sparkfun/SparkFun_Red_Vision_Camera_Board_HM01B0/README.md

SparkFun Red Vision Camera Board - HM01B0 (Color)
================================================
SparkFun Red Vision Camera Board - HM01B0 (Color) (https://www.sparkfun.com/sparkfun-red-vision-camera-board-hm01b0-color.html)

The SparkFun Red Vision Camera Board - HM01B0 is a breakout board for the HM01B0 320 x 320 color camera module from Himax<sup>&copy;</sup>. The Camera Board breaks out all the pins from the HM01B0's ribbon cable to three sets of 0.1"-spaced plated through-hole (PTH) headers for users to easily access. We designed the Red Vision Camera Board - HM01B0 to work both as a standalone breakout board and also as a compliment to the [SparkFun Red Vision Touch Display for Pico](https://www.sparkfun.com/sparkfun-red-vision-touch-display-for-pico.html) to add live image processing as well as advanced features including object and contour detection among others to the [Experiential Robotics Platform (XRP) Kit](https://www.sparkfun.com/experiential-robotics-platform-xrp-kit.html) using a SparkFun MicroPython port of the popular OpenCV image processing library. We've included both of these boards in the [SparkFun Red Vision Kit for XRP ](https://www.sparkfun.com/sparkfun-pico-vision-kit-for-xrp.html) for those who'd like to get everything they need to quickly and easily add a camera and touchscreen display to their XRP Robot with no soldering required. **Note:** This standalone version of the Red Vision Camera Board - HM01B0 does *not* come with headers soldered to the board.

Repository Contents
-------------------
 
* **/Hardware** - Eagle design files (.brd, .sch)

Documentation
--------------
* **[SparkFun Red Vision MicroPython Package](https://github.com/sparkfun/red_vision/tree/main)** - MicroPython package for the SparkFun Red Vision Camera Board - HM01B0 (Color).
* **[SparkFun MicroPython OpenCV](https://github.com/sparkfun/micropython-opencv)** - MicroPython port of OpenCV code library.
* **[SparkFun MicroPython Firmware Releases](https://github.com/sparkfun/micropython/releases)** - SparkFun MicroPython firmware releases.
* **[SparkFun Red Vision Kit for XRP Hookup Guide](https://docs.sparkfun.com/SparkFun_Red_Vision_Kit_for_XRP/introduction)** - Basic hookup guide for the SparkFun Red Vision Kit for XRP (includes the Red Vision Camera Board - HM01B0).

Product Versions
----------------
* [SEN-29468](https://www.sparkfun.com/sparkfun-red-vision-camera-board-hm01b0-color.html) - Initial release of the Red Vision Camera Board - HM01B0 (Color)

License Information
-------------------

This product is _**open source**_! 

Please review the LICENSE.md file for license information. 

If you have any questions or concerns on licensing, please contact technical support on our [SparkFun forums](https://forum.sparkfun.com/viewforum.php?f=152).

Distributed as-is; no warranty is given.

- Your friends at SparkFun.
