sparkfun/SparkFun_Red_Vision_Camera_Board_HM01B0/Hardware/SparkFun_Red_Vision_Camera_Board_HM01B0.kicad_sch

## KiCad design Hardware/SparkFun_Red_Vision_Camera_Board_HM01B0.kicad_sch (2025-09-04)

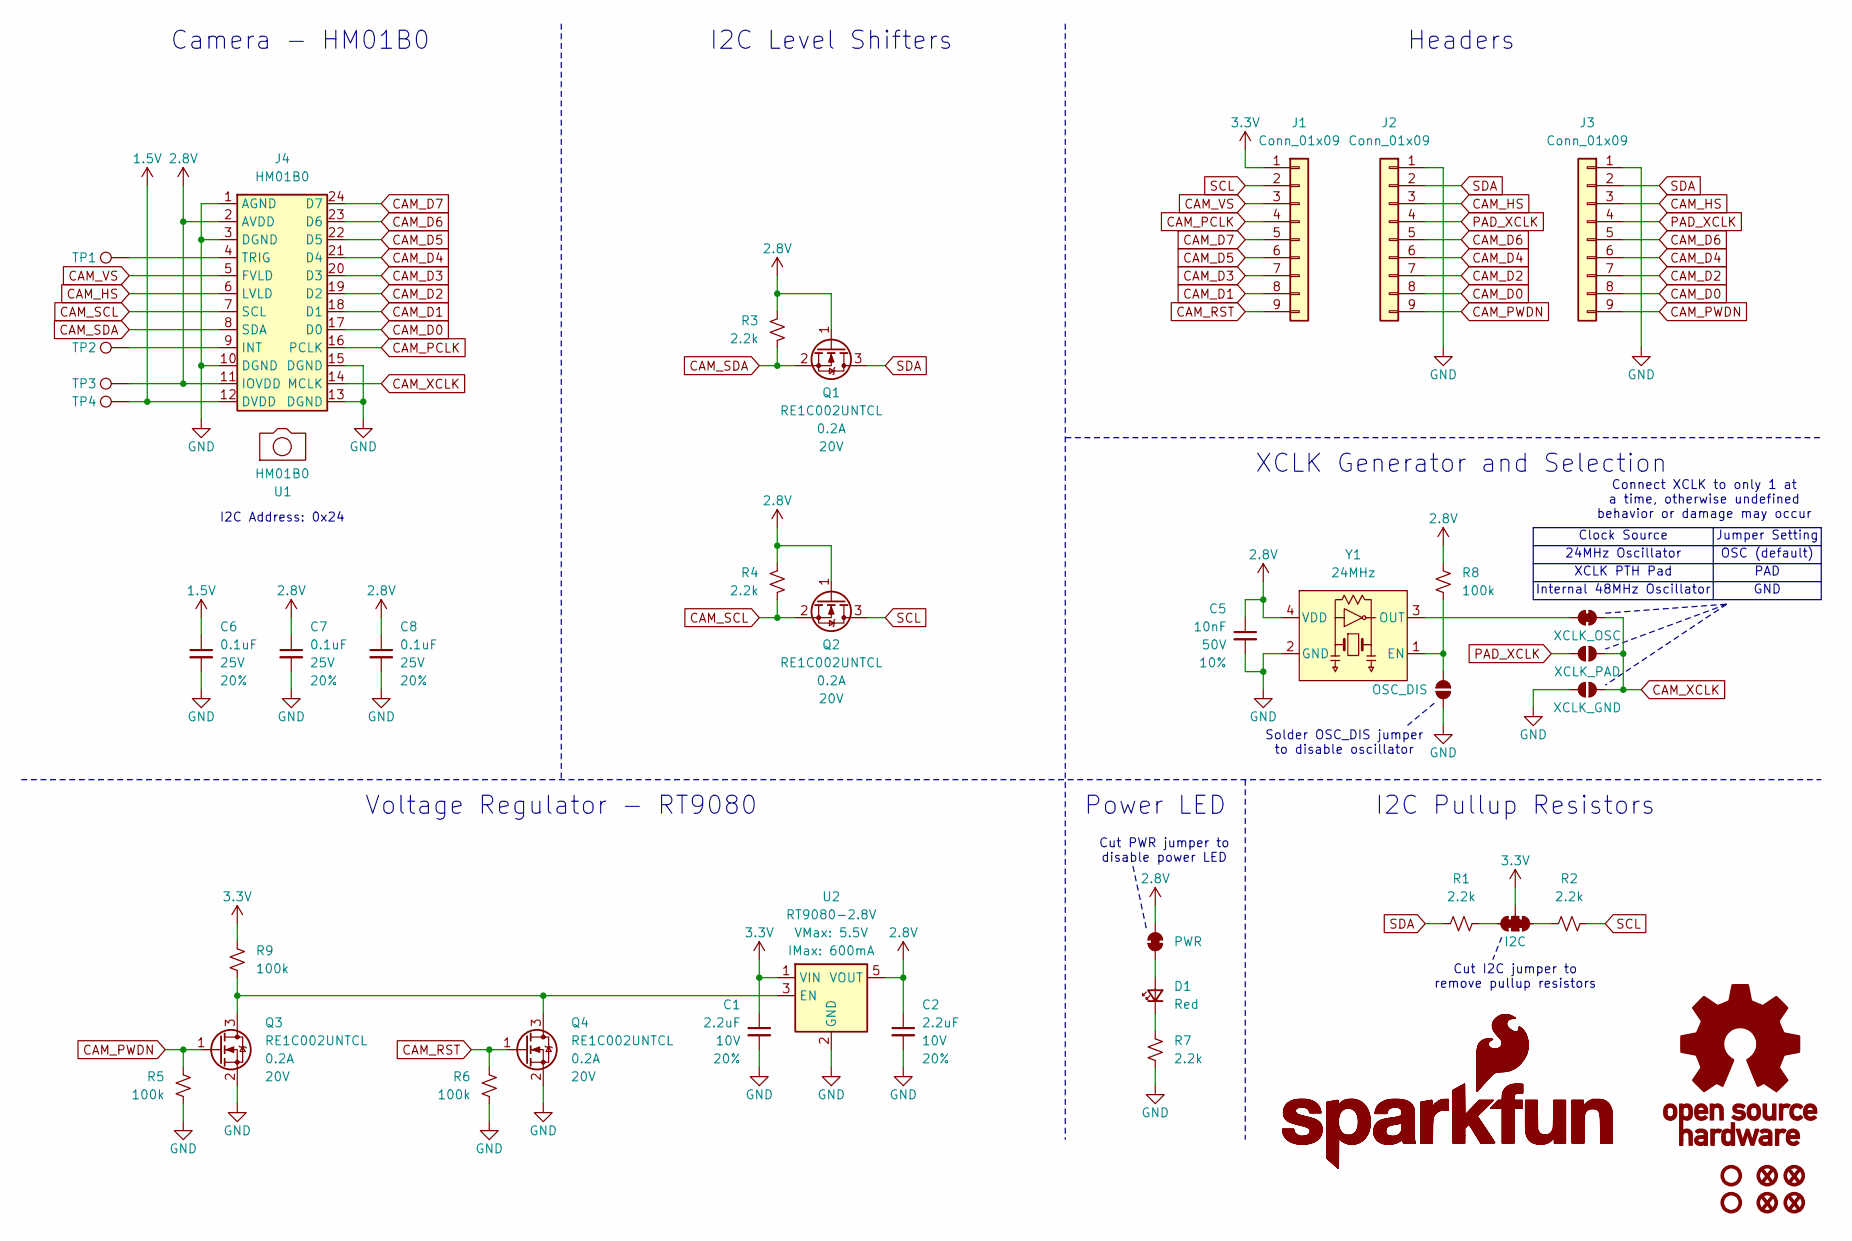
[picture p1: schematic SparkFun_Red_Vision_Camera_Board_HM01B0.kicad_sch]

Parts:
C1, C2: 2.2uF; C_0603_1608Metric; Voltage 10V; Tolerance 20%
C5: 10nF; C_0603_1608Metric; Voltage 50V; Tolerance 10%
C6, C7, C8: 0.1uF; C_0603_1608Metric; Voltage 25V; Tolerance 20%
D1: Red; LED_0603_1608Metric_Red
FID1, FID2, FID3, FID4: Fiducial_0.5mm; Fiducial_0.5mm_Mask1mm
G1: SparkFun_Logo; SparkFun_Logo_8mm
G2: SparkFun_Logo
G3: OSHW_Logo; Creative_Commons_License
J1, J2, J3: Conn_01x09; 1x09
J4: HM01B0; FPC_2x12-1MP_P0.4mm
JP1: I2C; Jumper_3_NC-2_Trace
JP2: XCLK_PAD; Jumper_2_NO_NoSilk
JP3: XCLK_OSC; Jumper_2_NC_Trace_NoSilk
JP5: OSC_DIS; Jumper_2_NO
JP6: XCLK_GND; Jumper_2_NO_NoSilk
JP7: PWR; Jumper_2_NC_Trace
Q1, Q2, Q3, Q4: RE1C002UNTCL; SC-89 SOT-490
R1, R2, R3, R4, R7: 2.2k; R_0603_1608Metric
R5, R6, R8, R9: 100k; R_0603_1608Metric
ST1, ST2: Standoff
TP1, TP2, TP3, TP4: 1.25mm; TestPoint-1.25mm
U1: HM01B0; HM01B0-ANA-00FT870
U2: RT9080-2.8V; SOT23-5
Y1: 24MHz; Crystal_SMD_3.2x2.5mm

Connections:
1.5V: C6.1, J4.12 (DVDD), TP4.1
2.8V: C2.1, C5.1, C7.1, C8.1, J4.2 (AVDD), J4.11 (IOVDD), JP7.2 (B), Q1.1 (G), Q2.1 (G), R3.2, R4.2, R8.2, TP3.1, U2.5 (VOUT), Y1.4 (VDD)
3.3V: C1.1, J1.1, JP1.2 (B), R9.1, U2.1 (VIN)
CAM_D0: J2.8, J3.8, J4.17 (D0)
CAM_D1: J1.8, J4.18 (D1)
CAM_D2: J2.7, J3.7, J4.19 (D2)
CAM_D3: J1.7, J4.20 (D3)
CAM_D4: J2.6, J3.6, J4.21 (D4)
CAM_D5: J1.6, J4.22 (D5)
CAM_D6: J2.5, J3.5, J4.23 (D6)
CAM_D7: J1.5, J4.24 (D7)
CAM_HS: J2.3, J3.3, J4.6 (LVLD)
CAM_PCLK: J1.4, J4.16 (PCLK)
CAM_PWDN: J2.9, J3.9, Q3.1 (G), R5.2
CAM_RST: J1.9, Q4.1 (G), R6.2
CAM_SCL: J4.7 (SCL), Q2.2 (S), R4.1
CAM_SDA: J4.8 (SDA), Q1.2 (S), R3.1
CAM_VS: J1.3, J4.5 (FVLD)
CAM_XCLK: J4.14 (MCLK), JP2.2 (B), JP3.2 (B), JP6.2 (B)
GND: C1.2, C2.2, C5.2, C6.2, C7.2, C8.2, J2.1, J3.1, J4.1 (AGND), J4.3 (DGND), J4.10 (DGND), J4.13 (DGND), J4.15 (DGND), JP5.1 (A), JP6.1 (A), Q3.2 (S), Q4.2 (S), R5.1, R6.1, R7.1, U2.2 (GND), Y1.2 (GND)
unnamed: D1.1 (K), R7.2
unnamed: D1.2 (A), JP7.1 (A)
unnamed: J4.4 (TRIG), TP1.1
unnamed: J4.9 (INT), TP2.1
unnamed: JP1.1 (A), R2.1
unnamed: JP1.3 (C), R1.2
unnamed: JP3.1 (A), Y1.3 (OUT)
unnamed: JP5.2 (B), R8.1, Y1.1 (EN)
unnamed: Q3.3 (D), Q4.3 (D), R9.2, U2.3 (EN)
PAD_XCLK: J2.4, J3.4, JP2.1 (A)
SCL: J1.2, Q2.3 (D), R2.2
SDA: J2.2, J3.2, Q1.3 (D), R1.1

Notes on the sheet:
Connect XCLK to only 1 at a time, otherwise undefined behavior or damage may occur
I2C Address: 0x24
24MHz Oscillator
Solder OSC_DIS jumper to disable oscillator
Jumper Setting
Cut I2C jumper to remove pullup resistors
Camera - HM01B0
Clock Source
Headers
I2C Pullup Resistors
OSC (default)
Voltage Regulator - RT9080
GND
Cut PWR jumper to disable power LED
Power LED
XCLK Generator and Selection
I2C Level Shifters
XCLK PTH Pad
Internal 48MHz Oscillator
PAD
