sparkfun/SparkFun_Red_Vision_Camera_Board_HM01B0/(commit log)

2025-03-12 Add initial design
    [SparkFun_Camera_Board_HM01B0.kicad_pcb, SparkFun_Camera_Board_HM01B0.kicad_sch]
2025-03-12 Silkscreen tweaks
    Move OSHW logo to back
    Add PWR label to power LED
    [SparkFun_Camera_Board_HM01B0.kicad_pcb]
2025-03-12 Actually save the schematic...
    [SparkFun_Camera_Board_HM01B0.kicad_sch]
2025-03-17 Design review updates
    Rearrange power control circuitry in schematic
    Add note to MCLK jumper in schematic
    Change camera connector silk pin labels
    Improve GND continuity
    Increase thermal spoke width
    Change In2.Cu to 2.8V instead of GND
    [SparkFun_Camera_Board_HM01B0.kicad_pcb, SparkFun_Camera_Board_HM01B0.kicad_sch]
2025-03-17 Change regulators to adjustable type
    Using adjustable regulators at least for prototypes. May change back to fixed regulators depending on testing
    [SparkFun_Camera_Board_HM01B0.kicad_pcb, SparkFun_Camera_Board_HM01B0.kicad_sch]
2025-03-17 Fix voltage regulator resistor orders
    Reference voltage is relative to VOUT instead of GND. Why???
    [SparkFun_Camera_Board_HM01B0.kicad_pcb, SparkFun_Camera_Board_HM01B0.kicad_sch]
2025-03-17 Fix HM01B0 PROD_ID
    [SparkFun_Camera_Board_HM01B0.kicad_pcb, SparkFun_Camera_Board_HM01B0.kicad_sch]
2025-05-07 Update voltage regulaotrs
    Remove 1.5V regulator (HM01B0 has internal 1.5V LDO)
    Change 2.8V regulator to RT9080 (much lower quiescent current and ripple than MIC5205)
    Add test points for 1.5V and 2.8V rails
    Adjust power LED position
    [SparkFun_Camera_Board_HM01B0.kicad_pcb, SparkFun_Camera_Board_HM01B0.kicad_sch]
2025-05-07 Bump version number to v10
    [SparkFun_Camera_Board_HM01B0.kicad_pcb, SparkFun_Camera_Board_HM01B0.kicad_sch]
2025-05-09 Design review updates
    Rename OSC jumper to OSC_DIS
    Add default text to MCLK jumper table
    Clarify MCLK PTH Pad in MCLK jumper table
    Fix typo in MCLK jumper table
    Fix LED datasheet
    Change MCLK pad silk labels to non-inverted
    Add GND via to fix GND peninsula on side of board
    Remove GND vias creating islands between data pins
    [SparkFun_Camera_Board_HM01B0.kicad_pcb, SparkFun_Camera_Board_HM01B0.kicad_sch]
2025-05-09 Change XCLK jumpers to 3x 2-pad jumpers
    [SparkFun_Camera_Board_HM01B0.kicad_pcb, SparkFun_Camera_Board_HM01B0.kicad_sch]
2025-05-09 Fix incorrectly connected nets
    [SparkFun_Camera_Board_HM01B0.kicad_pcb]
2025-05-09 Save schematic....
    [SparkFun_Camera_Board_HM01B0.kicad_sch]
2025-08-05 Updating hardware file names
    Updating hardware file names with new product name.
    [SparkFun_Red_Vision_Camera_Board_HM01B0.kicad_pcb, SparkFun_Red_Vision_Camera_Board_HM01B0.kicad_sch]
2025-09-04 Update libraries
    [SparkFun_Red_Vision_Camera_Board_HM01B0.kicad_pcb, SparkFun_Red_Vision_Camera_Board_HM01B0.kicad_sch]
